badgeteam/hackerhotel-2024-hardware/README.md

# Hackerhotel 2024 badge

This repository contains the hardware desgin files for the Hackerhotel 2024 badge.

## License

Copyright 2024 Tilde.industries

Copyright 2024 Nicolai Electronics

This hardware design may be used under the terms of the [CERN-OHL-P](LICENSE) license.
