badgeteam/hackerhotel-2024-hardware/Misc/D2D8409C.jpg

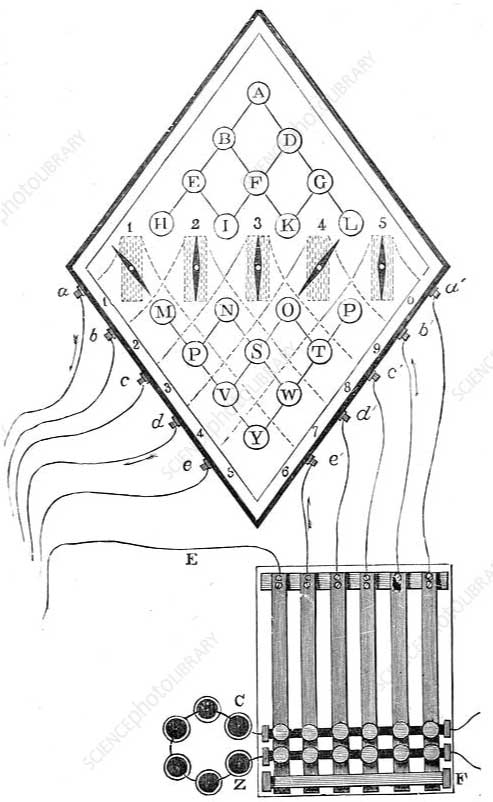
Misc/D2D8409C.jpg
