badgeteam/hackerhotel-2024-hardware/Misc/Hackerhotel.png

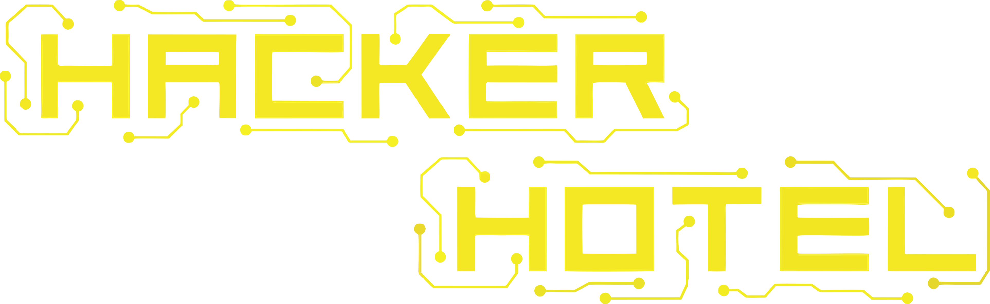
Misc/Hackerhotel.png
