badgeteam/hackerhotel-2024-hardware/Production/bom.xls

Comment | Designator | Footprint | JLCPCB Part # | quantity | quantity scaled
LED_Small | D5,D6,D7,D8,D9,D10,D11,D12,D13,D14,D15,D16,D17,D18,D19,D20,D21,D22,D23,D24 | BamboulabFootprints:XL-1606UOCSideStickerLED | C965861 | 20 | 10000
1A | F1 | tanoshii:Fuse_0805_2012Metric | C269107 | 1 | 500
NSR0320MW2T1G | D1,D2,D3,D4,D25 | tanoshii:D_SOD-323 | C48192 | 5 | 2500
1u | C14,C15,C16,C18,C19,C20,C21,C22,C23 | Capacitor_SMD:C_0805_2012Metric | C376929 | 9 | 4500
CH32V003F4U6 | U5 | vfd:QFN-20-1EP_3x3mm_P0.4mm_EP1.65x1.65mm | C5299908 | 1 | 500
Micro_SD_Card | J3 | tanoshii:MicroSD-SOFNG-TF-002-H18 | C125814 | 1 | 500
E-Paper | J6 | tanoshii:Hirose_FH12-24S-0.5SH_1x24-1MP_P0.50mm_Horizontal | C202112 | 1 | 500
100n | C2,C4,C5,C9,C13 | Capacitor_SMD:C_0805_2012Metric | C476766 | 5 | 2500
USB-C | J4 | tanoshii:USB_C_Receptacle_HRO_TYPE-C-31-M-12 | C165948 | 1 | 500
SW_SPDT | SW6 | Button_Switch_SMD:SW_SPDT_PCM12 | C319020 | 1 | 500
Battery | J5 | tanoshii:JST_S2B-ZR-SM4A-TF(LF)(SN) | C265329 | 1 | 500
30 | R23,R24,R25,R26,R27 | Resistor_SMD:R_0805_2012Metric | C25305 | 5 | 2500
AP2302B | Q1,Q2,Q3 | tanoshii:SOT-23 | C406812 | 3 | 1500
22u | C6,C10,C11 | Capacitor_SMD:C_0805_2012Metric | C602037 | 3 | 1500
SANYOU_SRD_Form_C | K1 | BamboulabFootprints:HRS1H-S-DC3V | C136110 | 1 | 500
Multi-Directional-Switches | SW1,SW2,SW3,SW4,SW5 | BamboulabFootprints:TM-2023 | C318951 | 5 | 2500
10k | R1,R6,R7,R8,R11,R14,R17,R28,R29,R30,R34,R43 | Resistor_SMD:R_0805_2012Metric | C510098 | 12 | 6000
2.2u | L1 | tanoshii:Inductor_MSC20FC | C375944 | 1 | 500
45.3k | R12 | Resistor_SMD:R_0805_2012Metric | C5266157 | 1 | 500
5.1k | R4,R5 | Resistor_SMD:R_0805_2012Metric | C2930296 | 2 | 1000
47u | L2 | tanoshii:L_1210_3225Metric | C83083 | 1 | 500
Breakoutpads | J2 | Connector_PinHeader_2.54mm:PinHeader_1x03_P2.54mm_Vertical | C2935909 | 1 | 500
XT4054K421MR-G | U3 | tanoshii:SOT-23-5 | C141405 | 1 | 500
4u7 | C17 | Capacitor_SMD:C_0805_2012Metric | C2918489 | 1 | 500
22p | C8 | Capacitor_SMD:C_0805_2012Metric | C5137614 | 1 | 500
10u | C7,C12 | Capacitor_SMD:C_0805_2012Metric | C105506 | 2 | 1000
2k | R13 | Resistor_SMD:R_0805_2012Metric | C3017846 | 1 | 500
100k | R16,R18,R19,R31,R32 | Resistor_SMD:R_0805_2012Metric | C2907293 | 5 | 2500
4.7k | R2,R3,R20 | Resistor_SMD:R_0805_2012Metric | C2907326 | 3 | 1500
27 | R9,R10,R21 | Resistor_SMD:R_0805_2012Metric | C2907314 | 3 | 1500
1k | R15,R35 | Resistor_SMD:R_0805_2012Metric | C3017842 | 2 | 1000
 | U2 |  | C133751 | 1 | 500
 | U4 |  | C55136 | 1 | 500
