badgeteam/hackerhotel-2024-hardware/HH2024 V1.4 Schematic.pdf

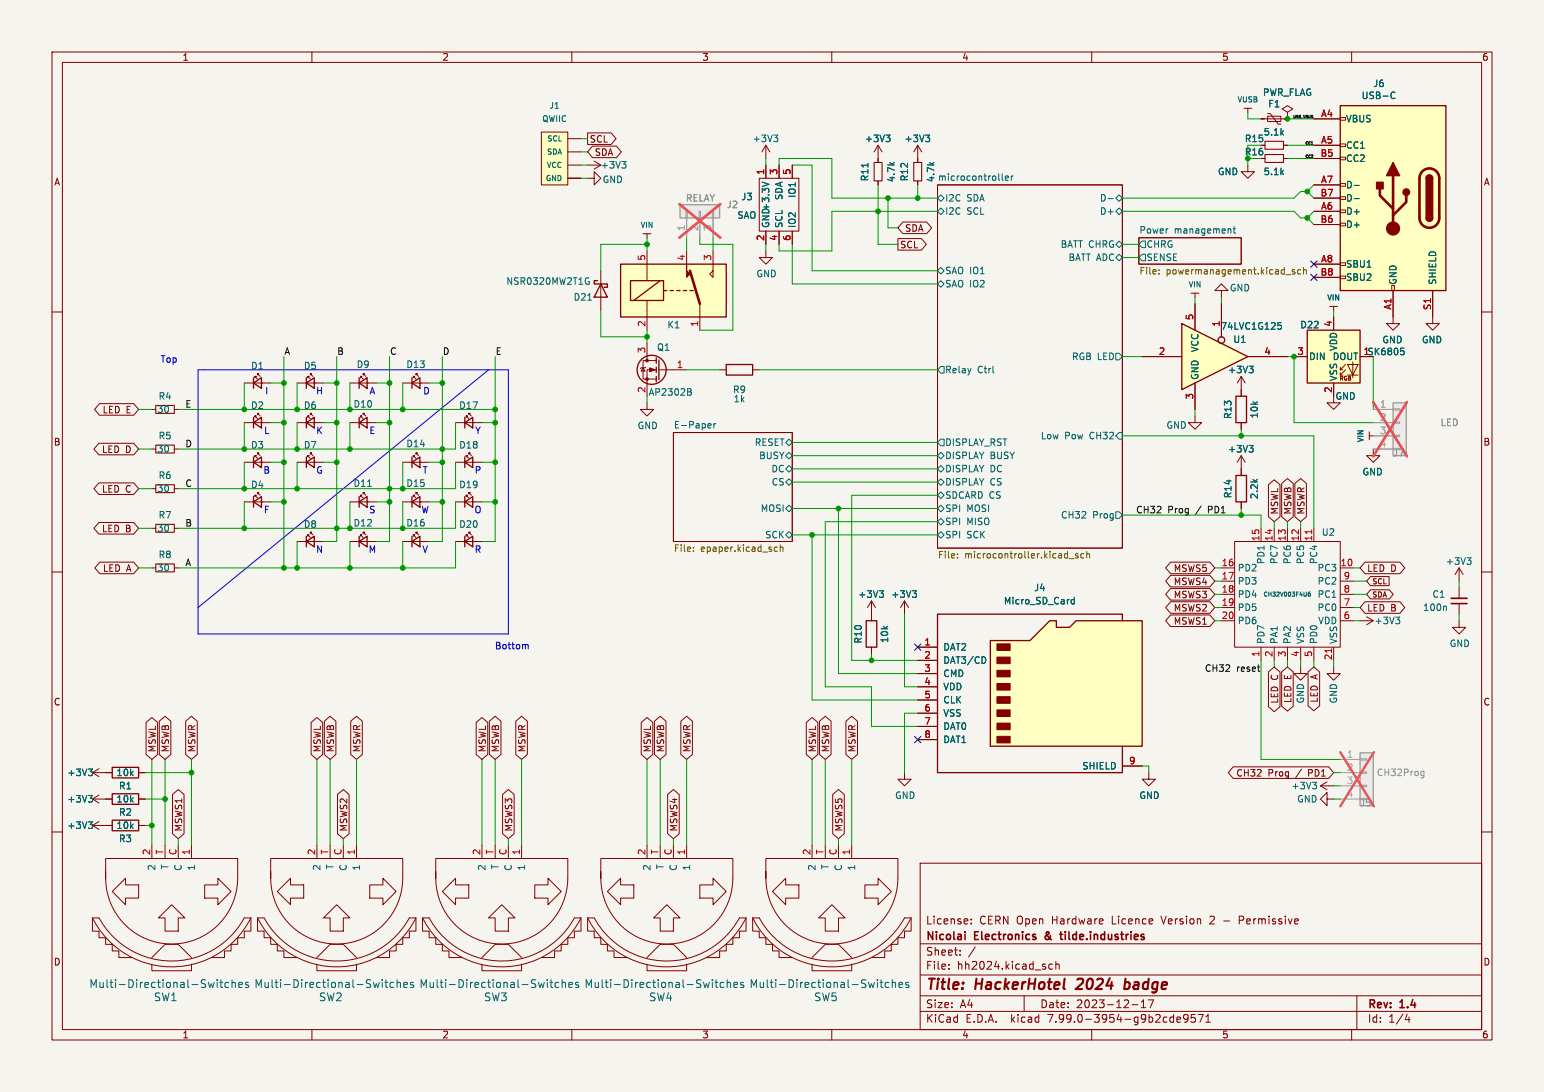
[picture p3: page 1]

Power management File: powermanagement.kicad_sch BUSY RESET DC

SPI MOSI SPI SCK DISPLAY DC

SCL LED D LED A LED C LED E CH32 Prog / PD1 MSWL MSWB

T SW5 Multi-Directional-Switches DAT2 1 DAT3/CD 2 CMD 3 VDD 4 CLK 5 VSS 6 DAT0 7 DAT1 8 SHIELD 9

Id: 1/4 Title: HackerHotel 2024 badge

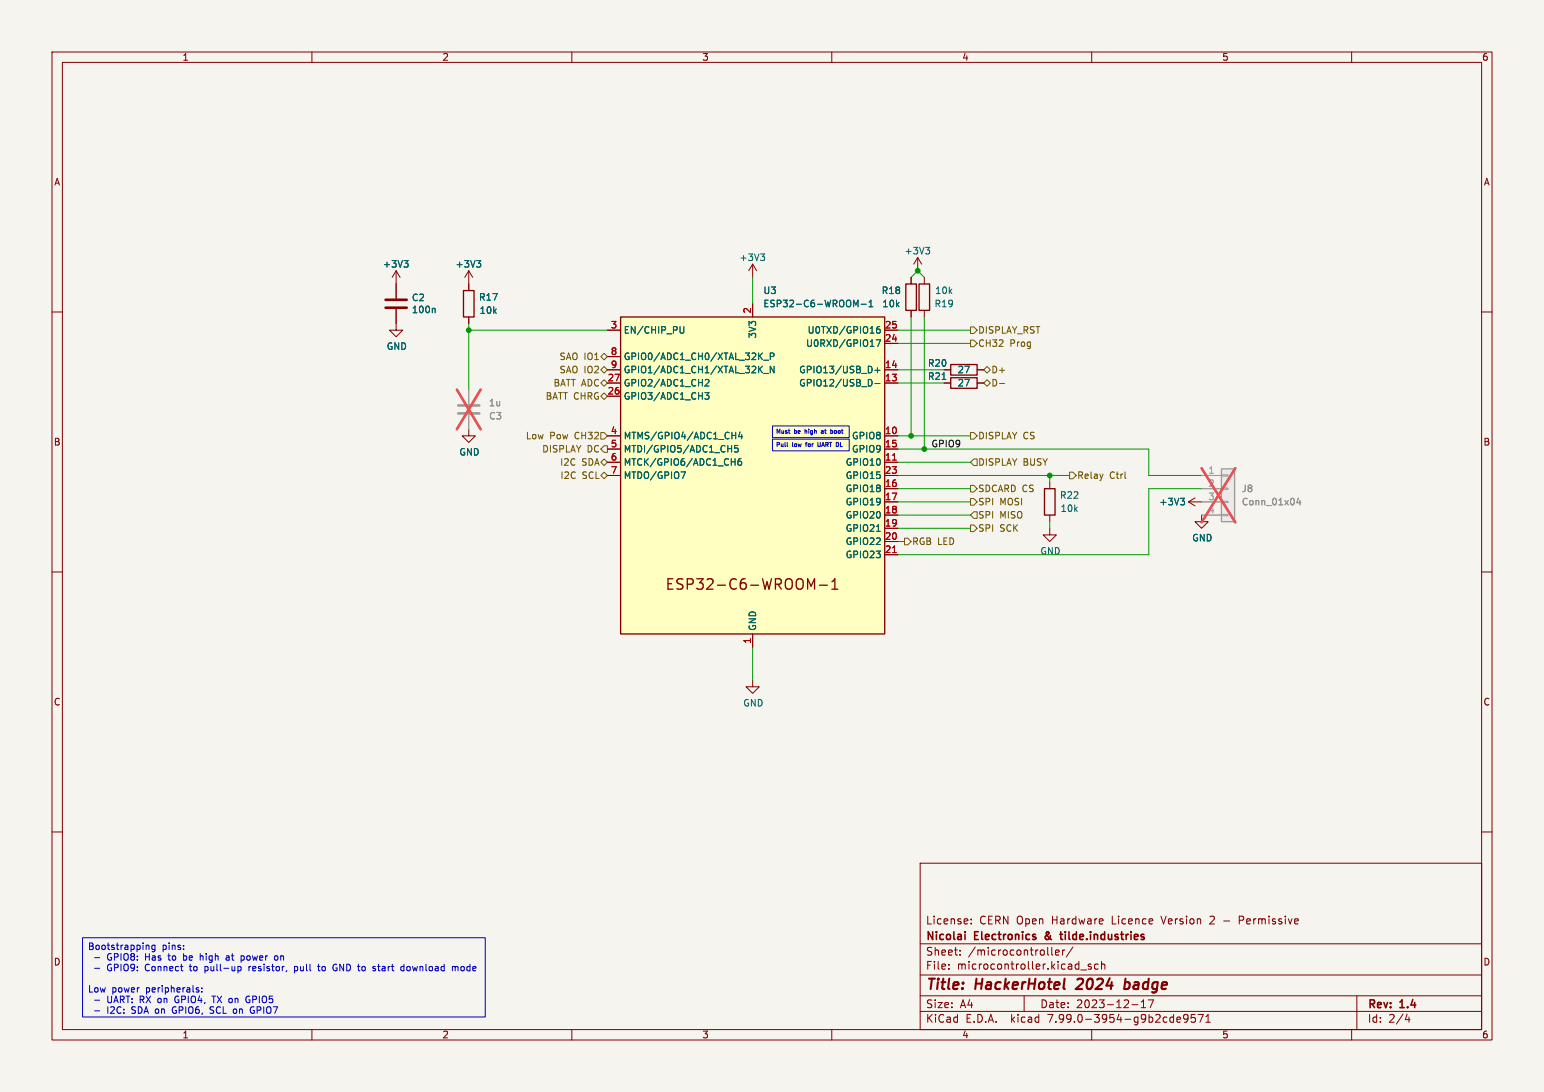
[picture p4: page 2]

2 GPIO22 20 GPIO23 21 GPIO15 23 U0RXD/GPIO17 24 U0TXD/GPIO16 25 GPIO3/ADC1_CH3 26 GPIO2/ADC1_CH2 27 EN/CHIP_PU 3 MTMS/GPIO4/ADC1_CH4 4 MTDI/GPIO5/ADC1_CH5 5 MTCK/GPIO6/ADC1_CH6 6 MTDO/GPIO7 7 GPIO0/ADC1_CH0/XTAL_32K_P 8 GPIO1/ADC1_CH1/XTAL_32K_N 9 U3ESP32-C6-WROOM-1 R20

SPI SCK DISPLAY_RST DISPLAY CS CH32 Prog D+

2 GPIO22 20 GPIO23 21 GPIO15 23 U0RXD/GPIO17 24 U0TXD/GPIO16 25 GPIO3/ADC1_CH3 26 GPIO2/ADC1_CH2 27 EN/CHIP_PU 3 MTMS/GPIO4/ADC1_CH4 4 MTDI/GPIO5/ADC1_CH5 5 MTCK/GPIO6/ADC1_CH6 6 MTDO/GPIO7 7 GPIO0/ADC1_CH0/XTAL_32K_P 8 GPIO1/ADC1_CH1/XTAL_32K_N 9 C3

SPI MOSI DISPLAY BUSY

Id: 2/4 Title: HackerHotel 2024 badge

Low power peripherals: - UART: RX on GPIO4, TX on GPIO5

- I2C: SDA on GPIO6, SCL on GPIO7

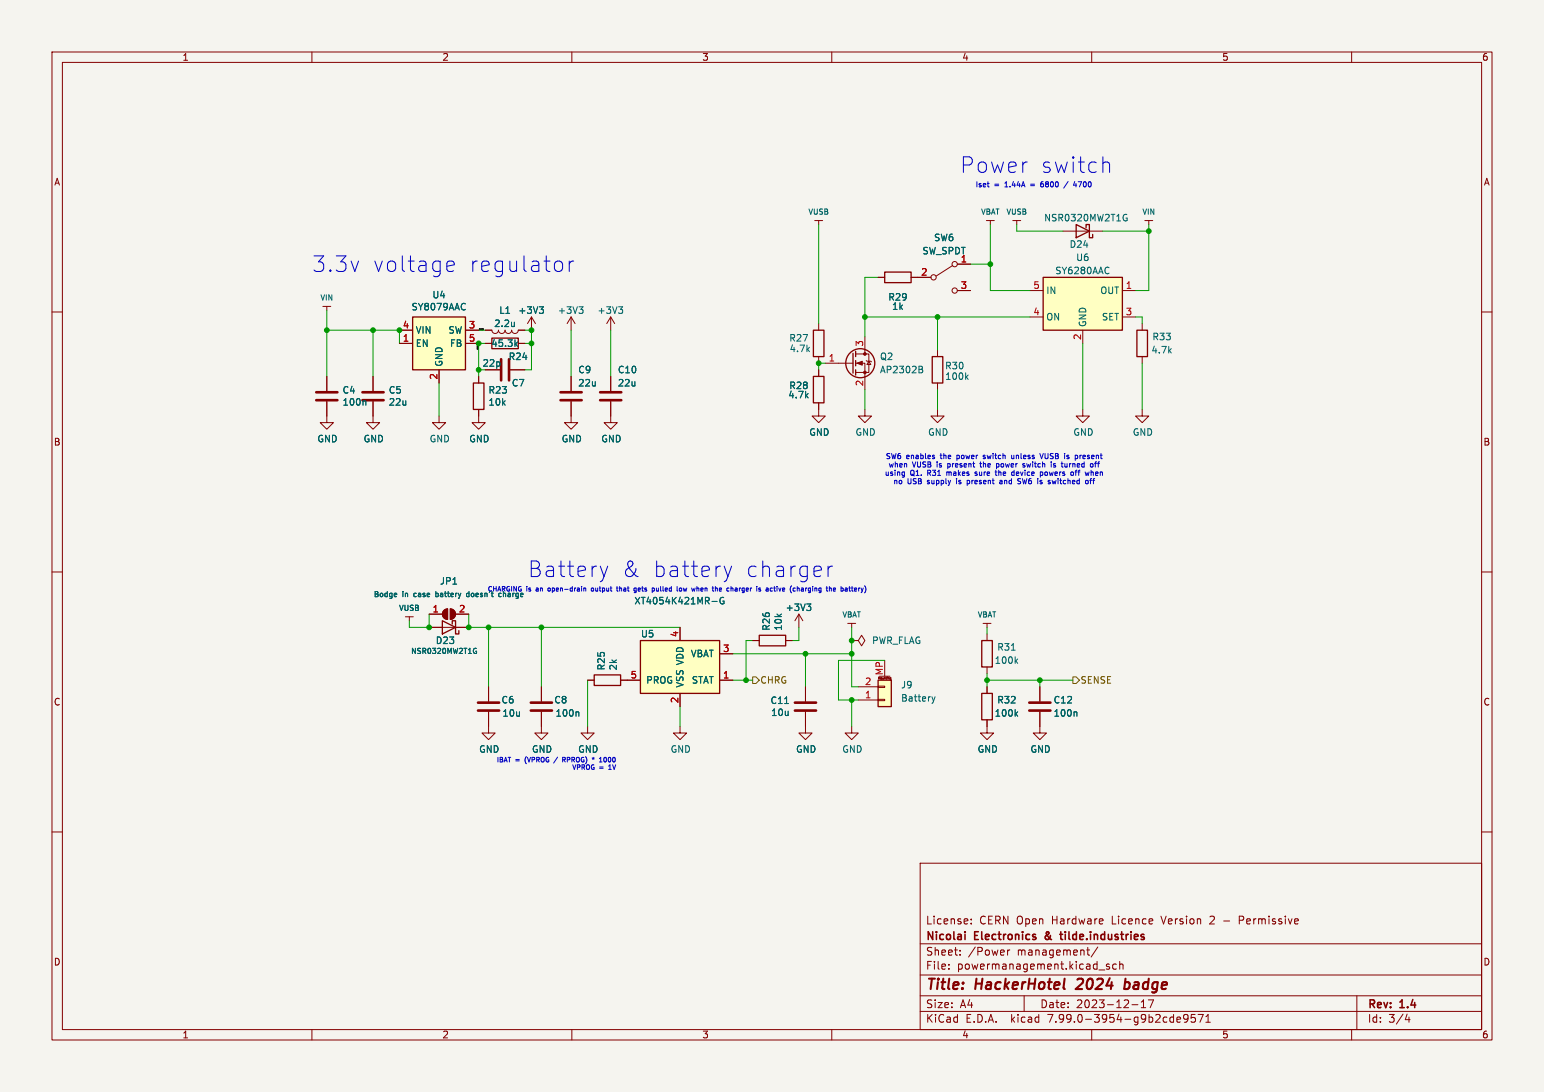
[picture p5: page 3]

Iset = 1.44A = 6800 / 4700 SW6 enables the power switch unless VUSB is present when VUSB is present the power switch is turned off using Q1. R31 makes sure the device powers off when

IBAT = (VPROG / RPROG) * 1000 VPROG = 1V Battery & battery charger

Id: 3/4 Title: HackerHotel 2024 badge

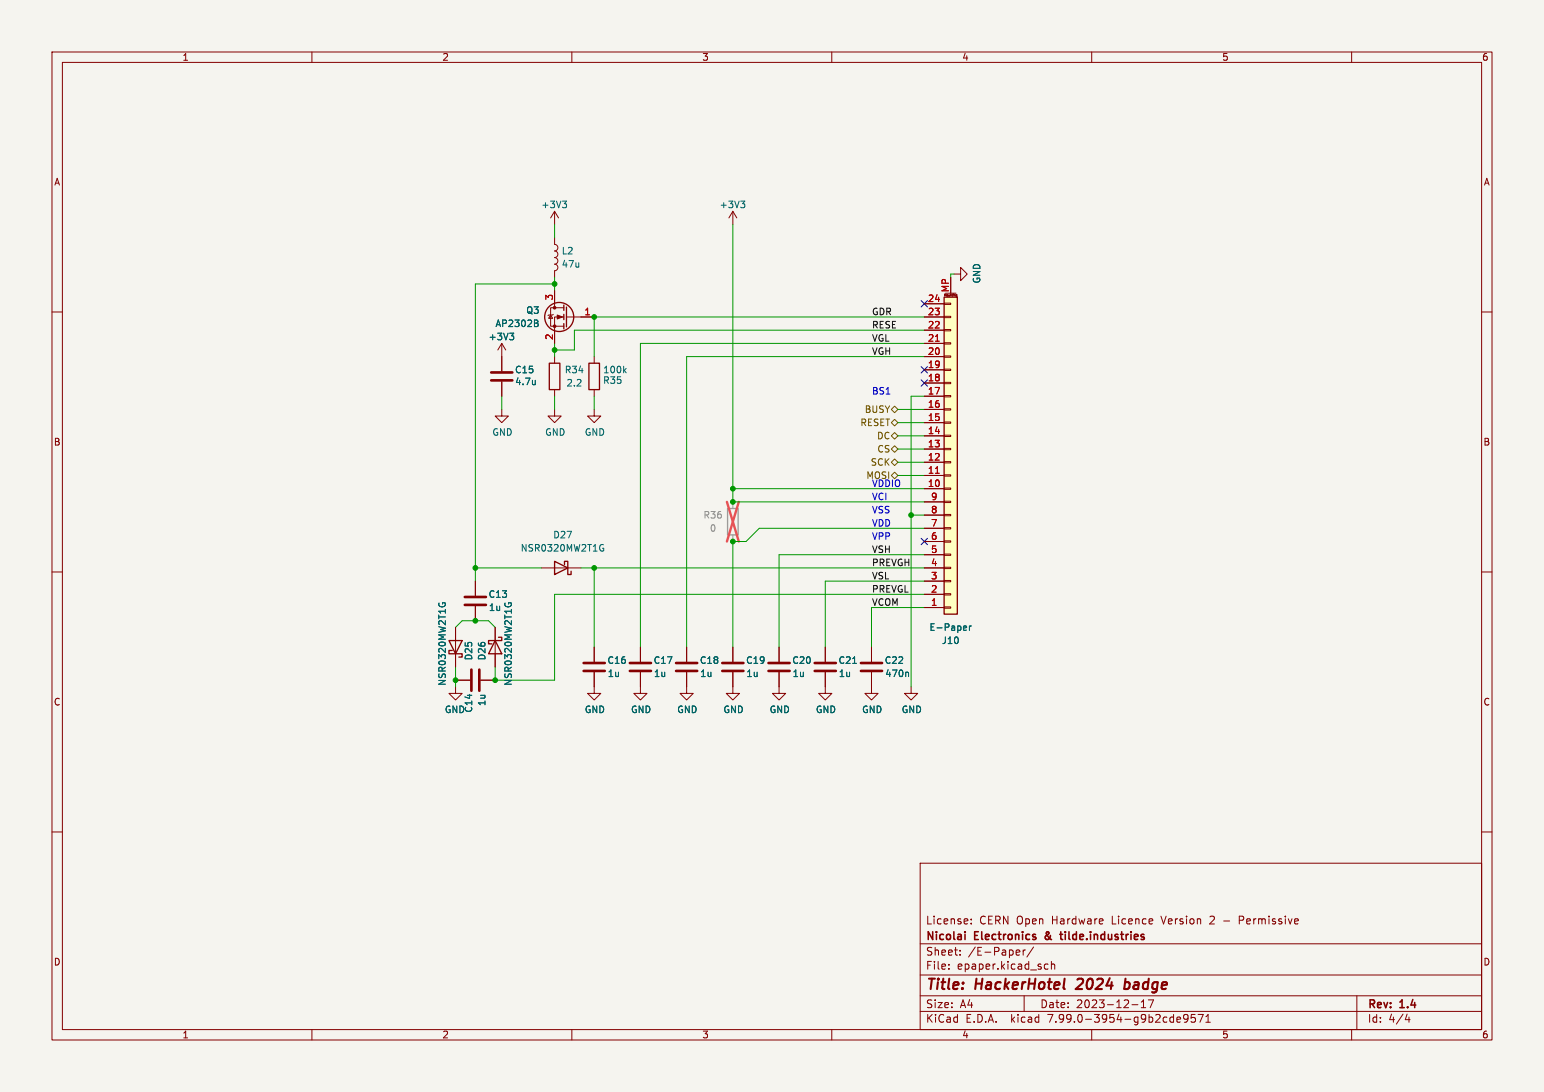
[picture p6: page 4]

9 MP VGH 20 20

Mounting 1
BUSY MOSI RESET VSH GDR

VGL RESE 22 22

VSL PREVGH | 4 4

PREVGL VCOM | 2 2

Id: 4/4 Title: HackerHotel 2024 badge
