badgeteam/hackerhotel-2024-hardware/hackerhotel-2024-hardware-renze/Schematic.pdf

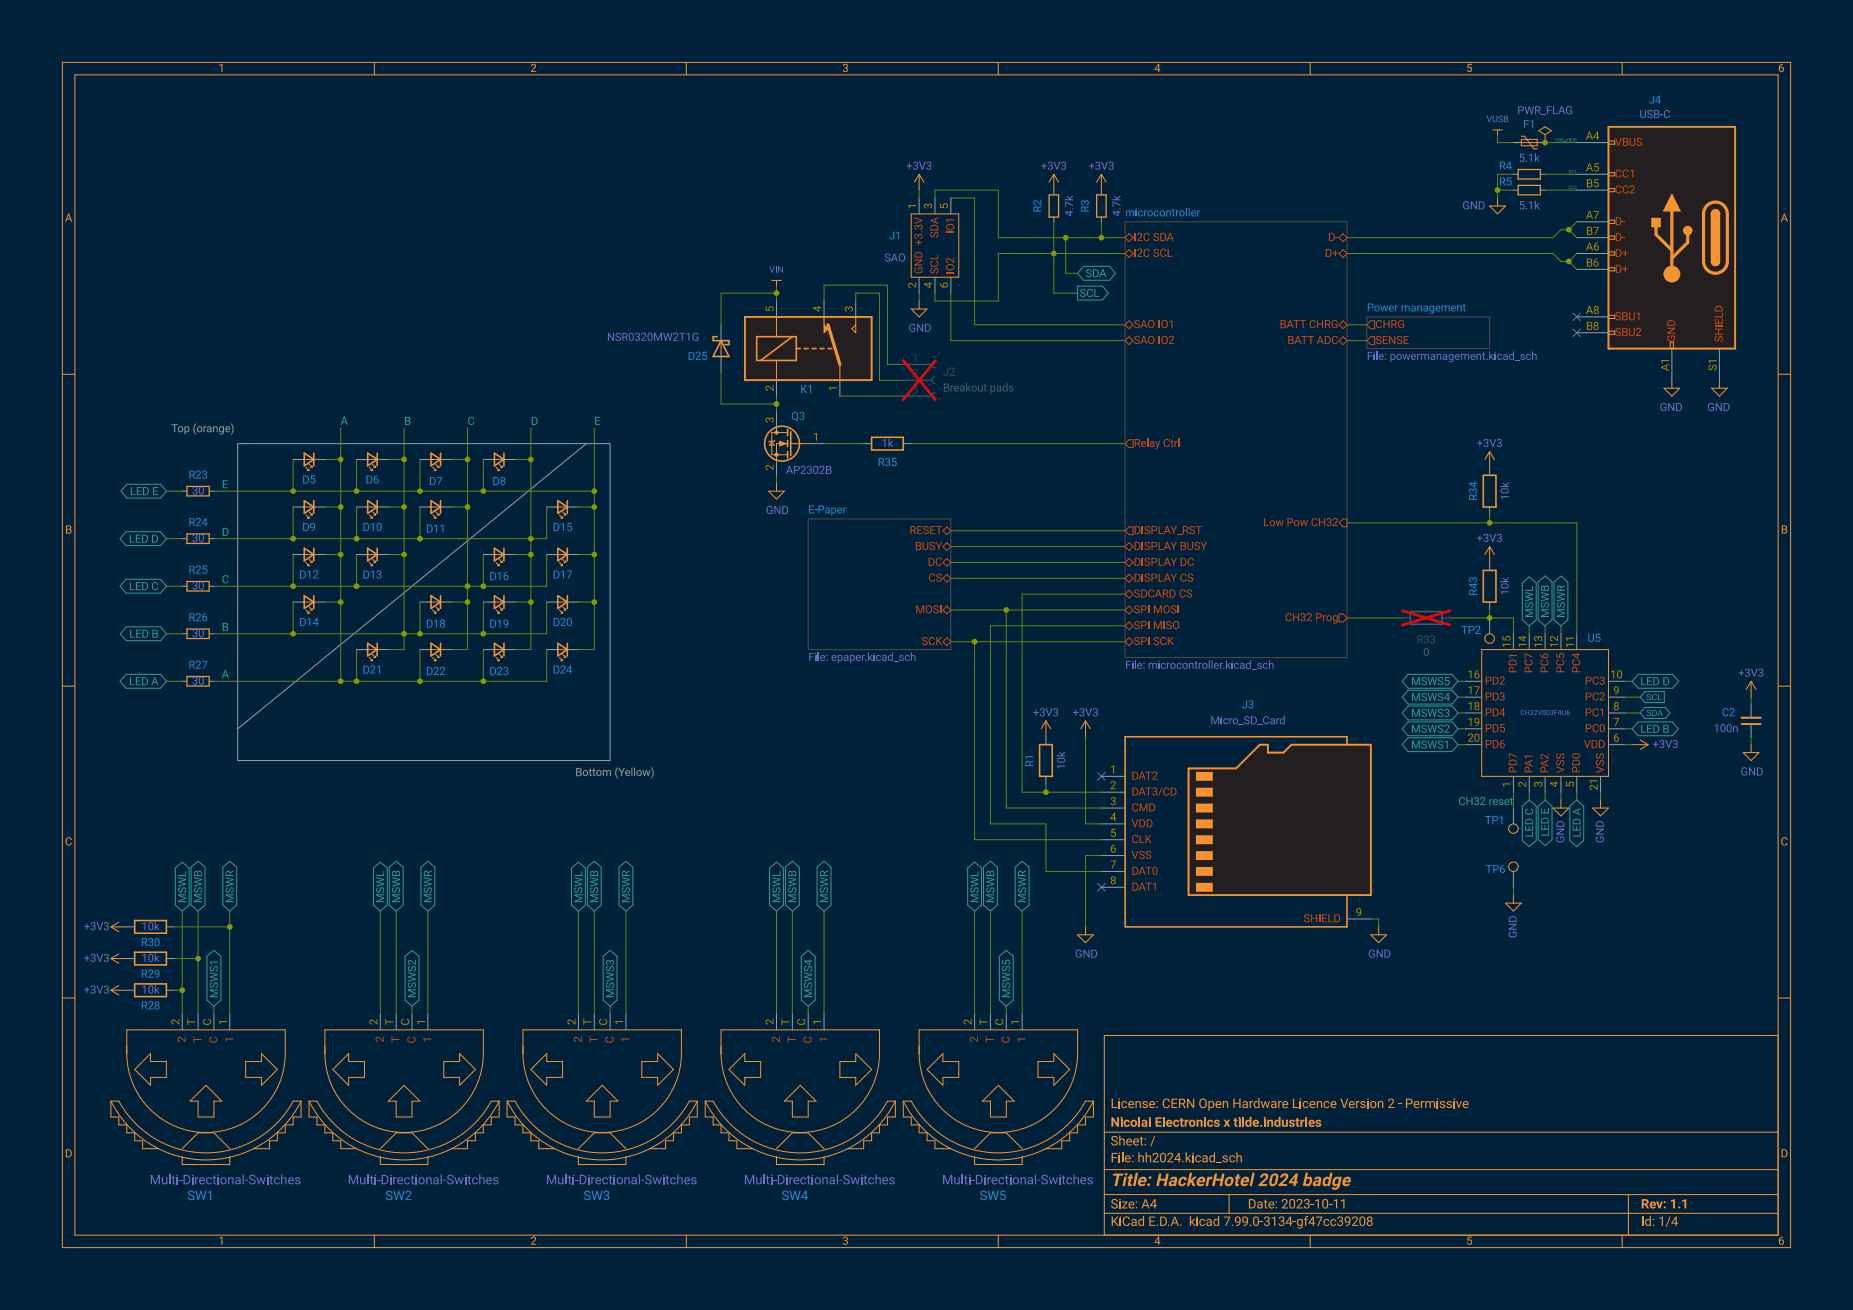
[picture p7: page 1]

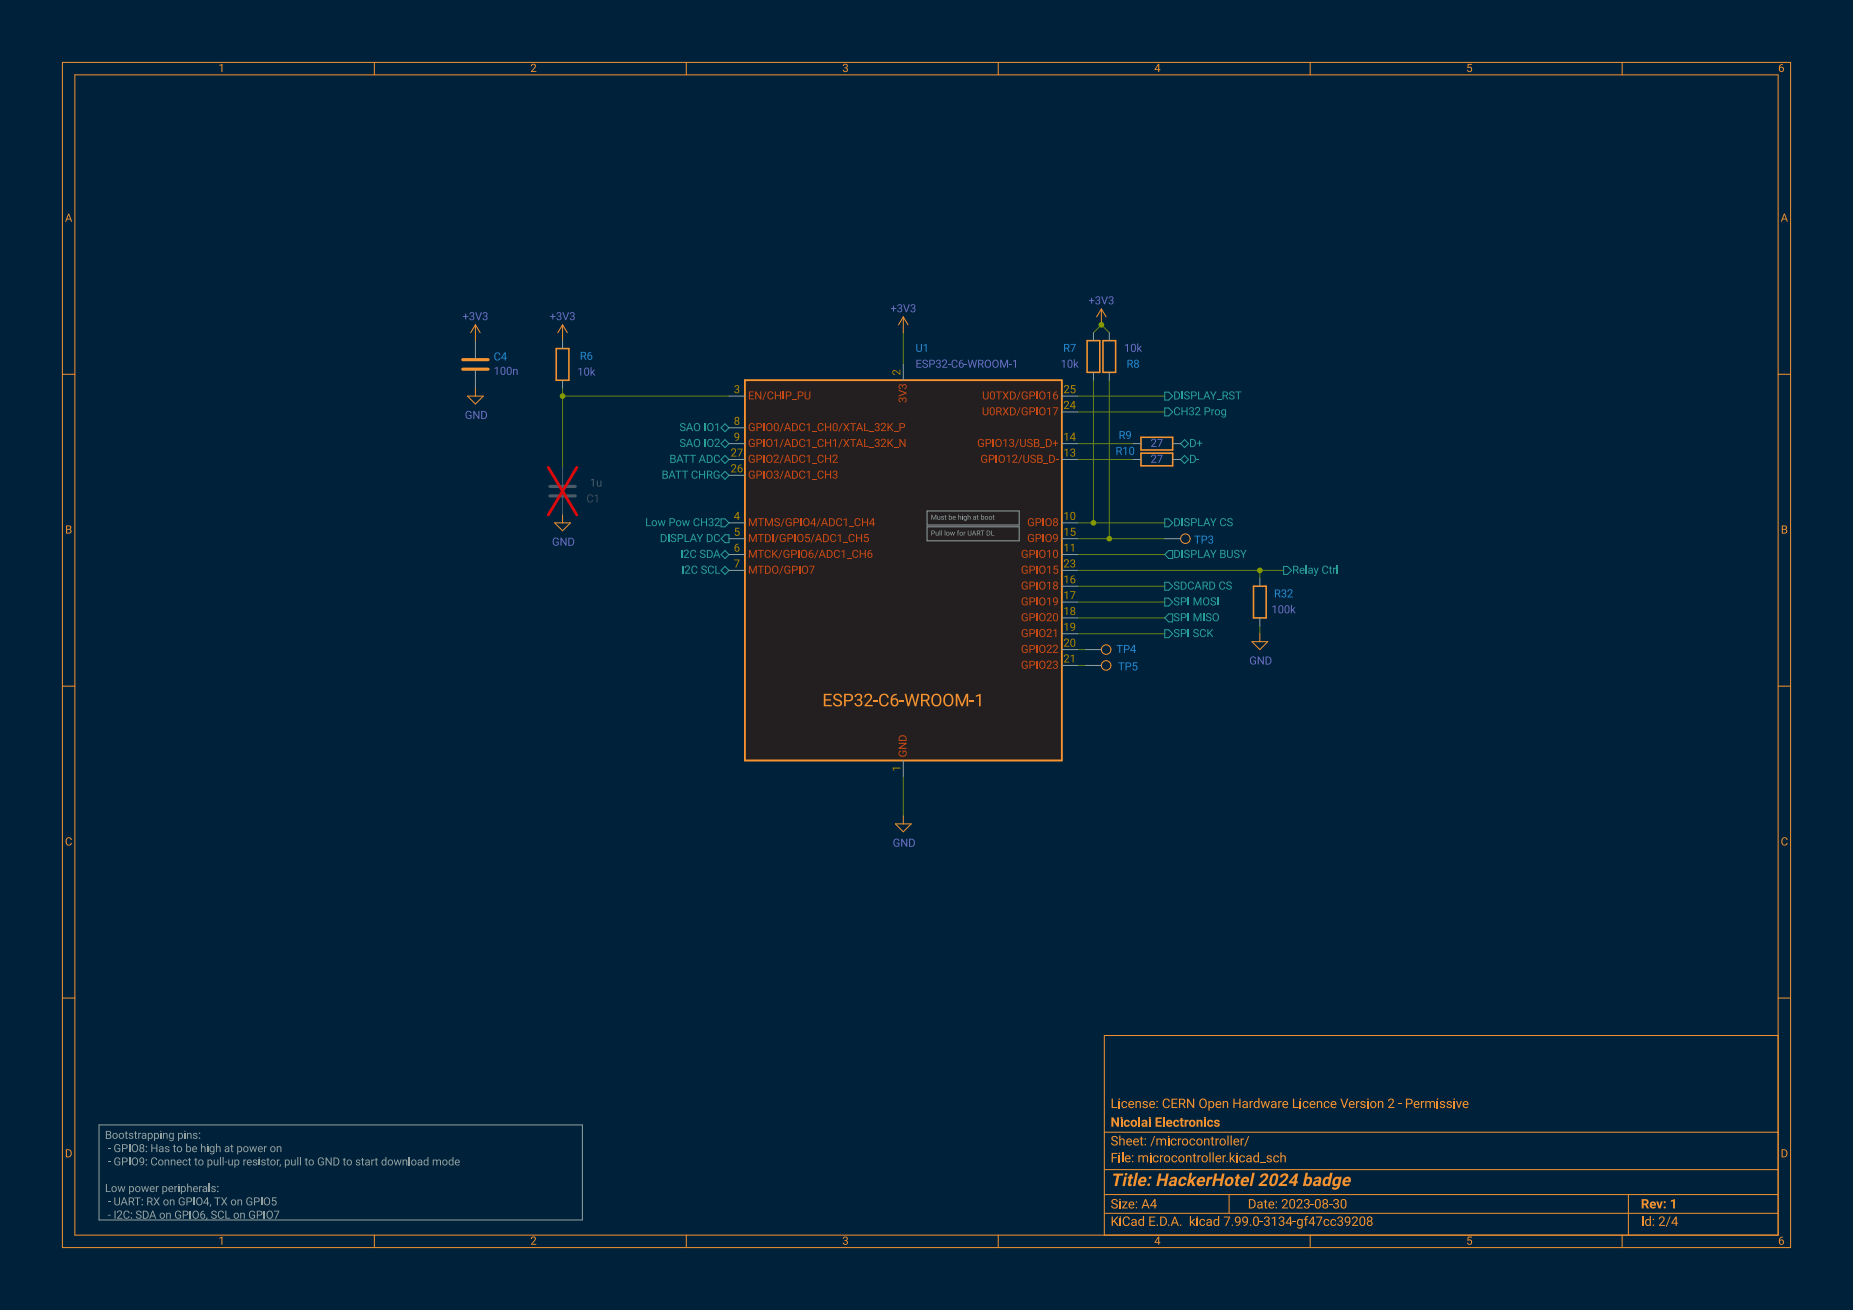
[picture p8: page 2]

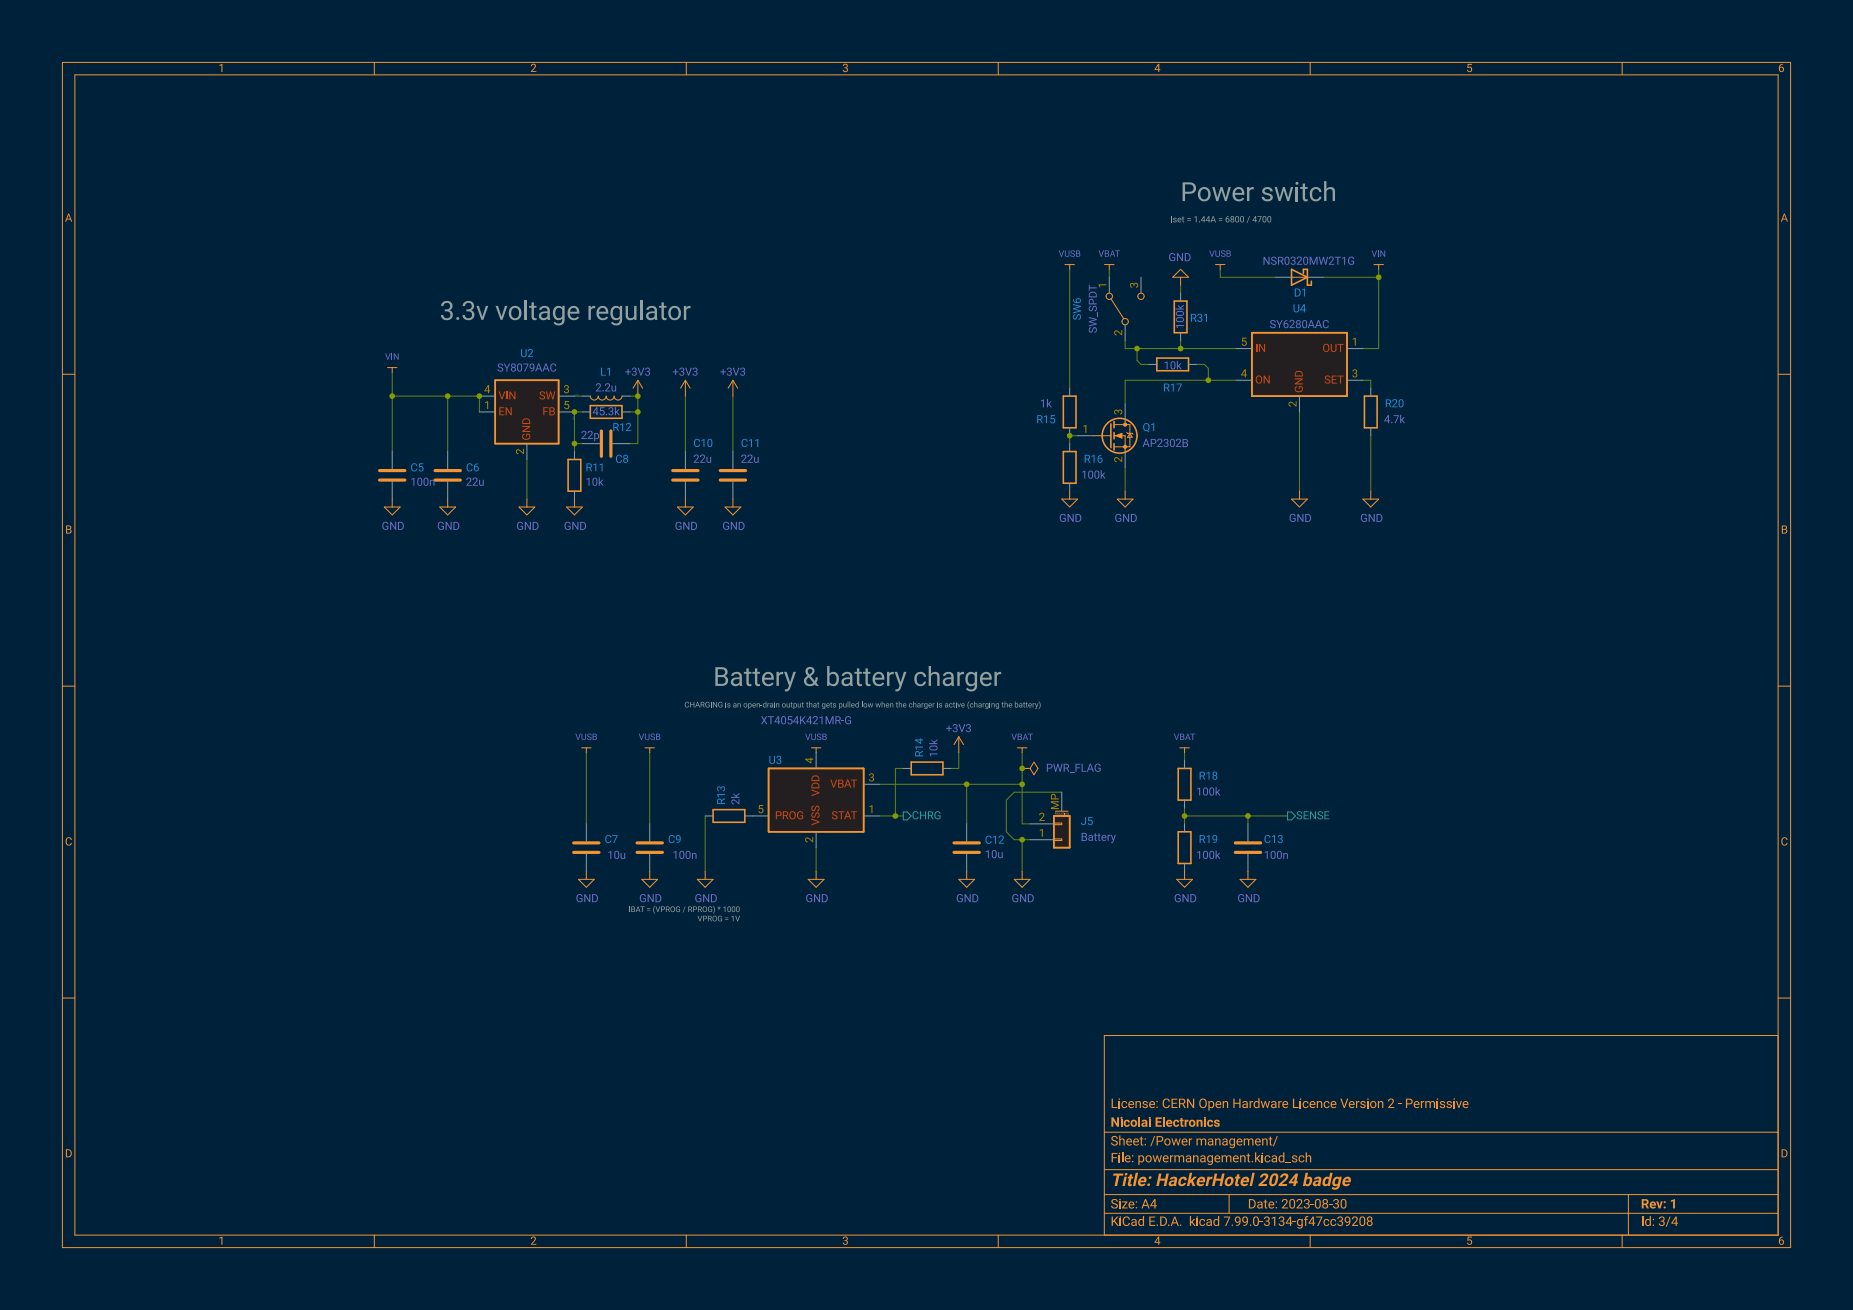
[picture p9: page 3]

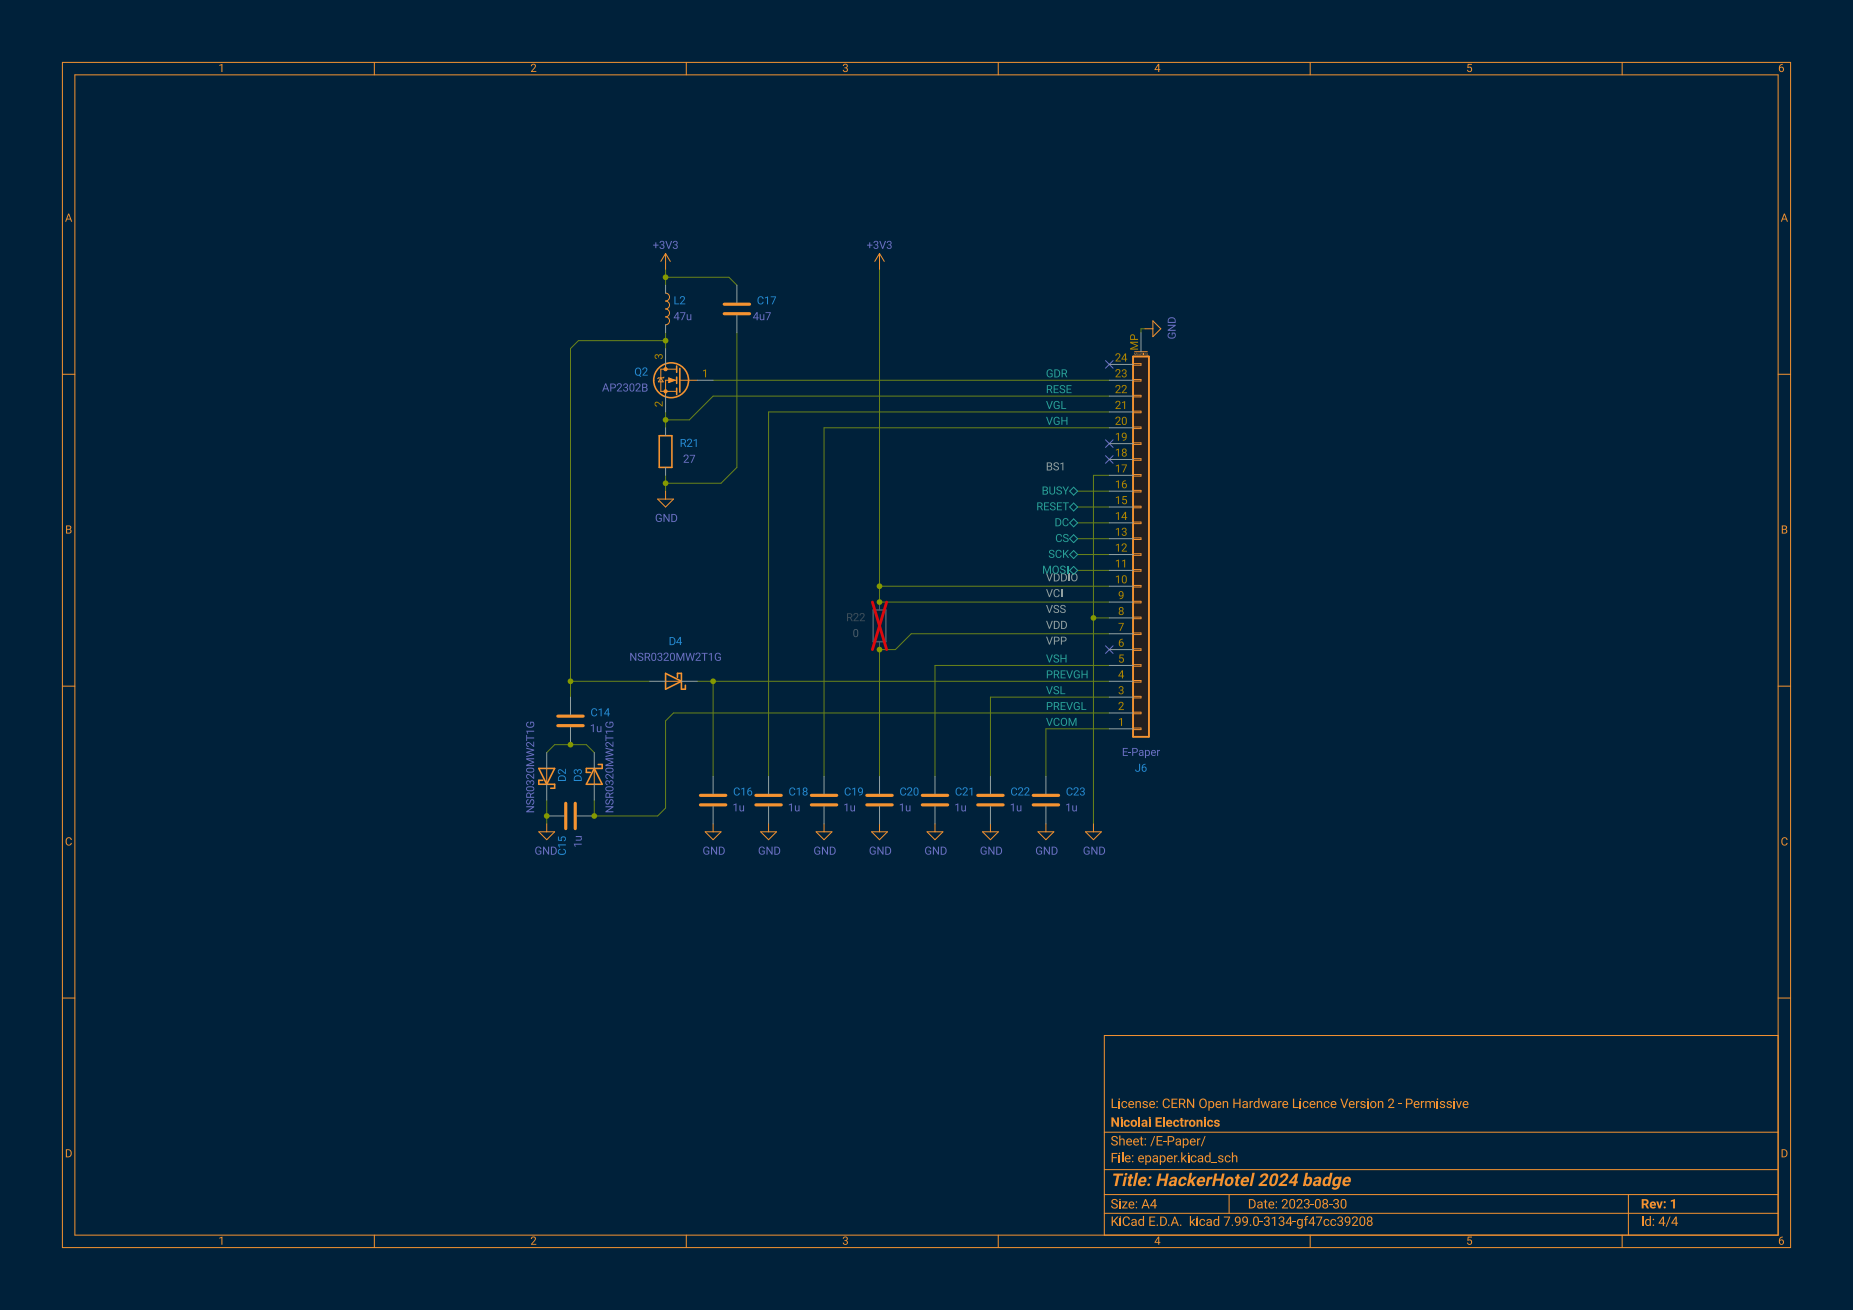
[picture p10: page 4]
