badgeteam/hackerhotel-2024-hardware/hackerhotel-2024-hardware-renze/test.pdf

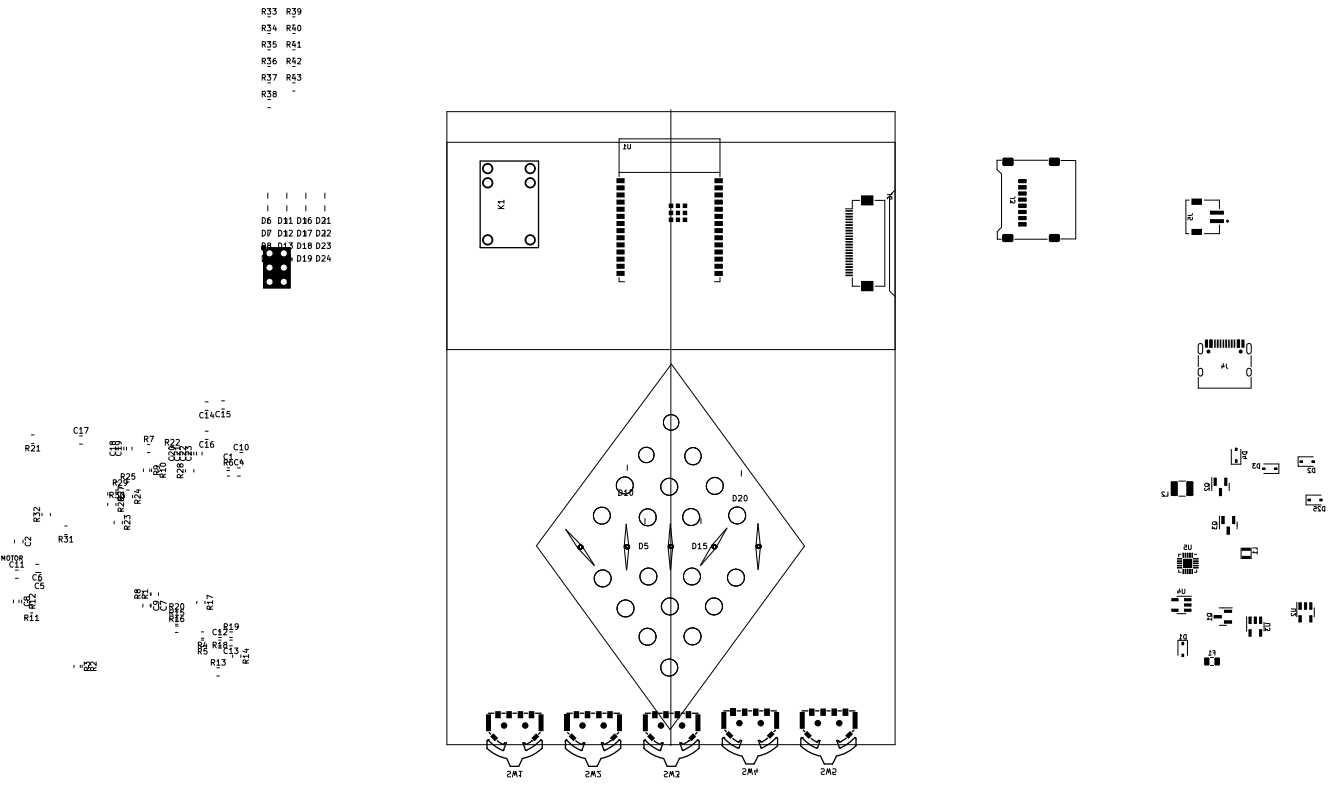
[picture p11: page 1]
