badgeteam/hackerhotel-2024-hardware/hackerhotel-2024-hardware-renze/hh2024.kicad_pcb

## KiCad design hackerhotel-2024-hardware-renze/hh2024.kicad_pcb (2023-10-17)

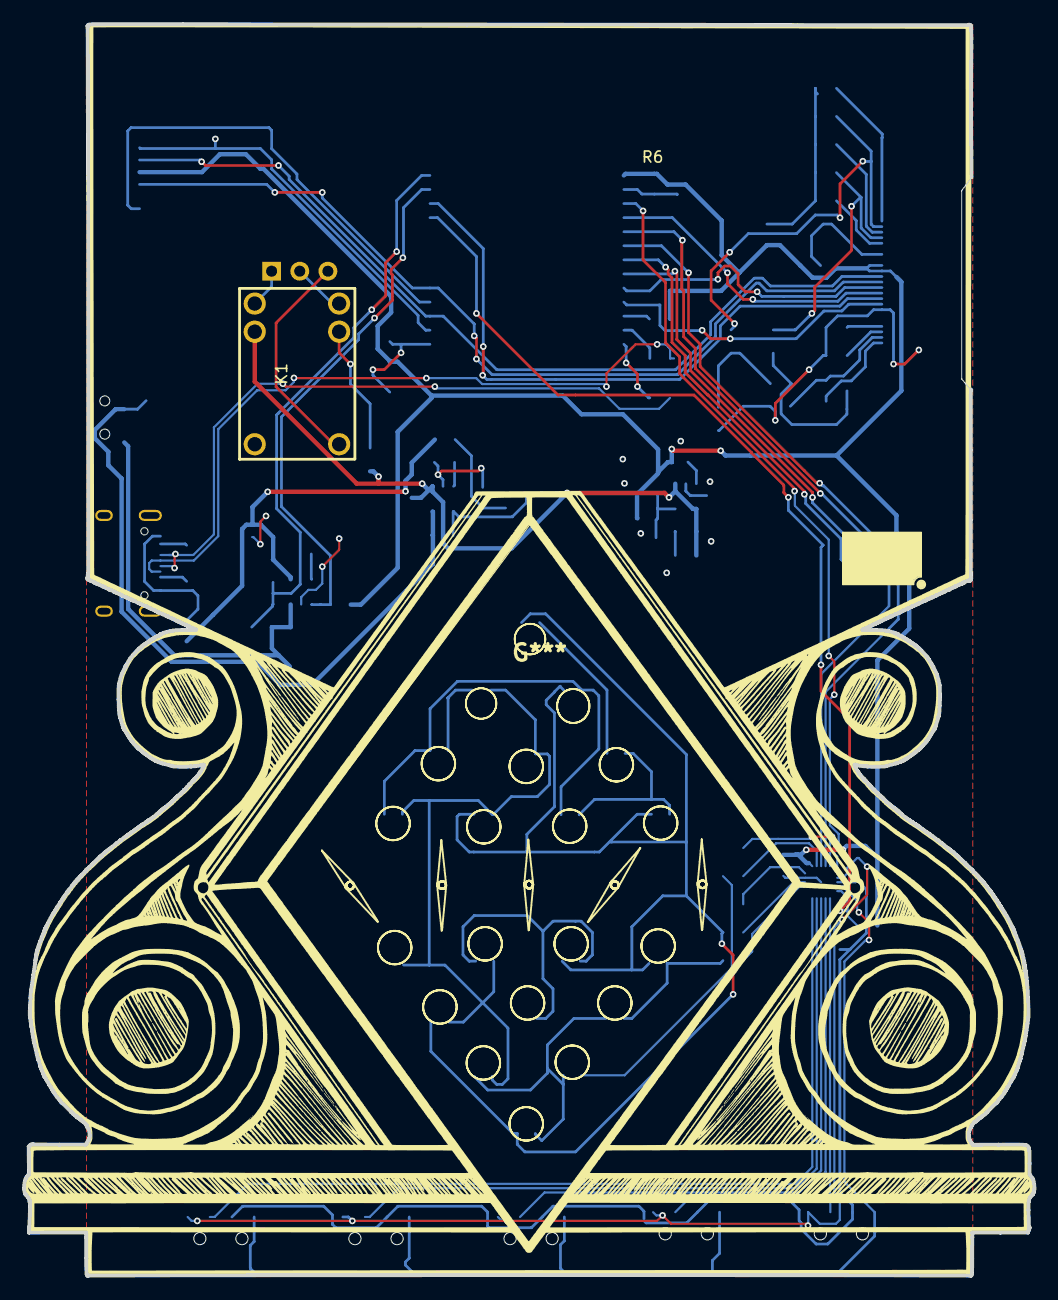
[picture p12: board hh2024.kicad_pcb from above]

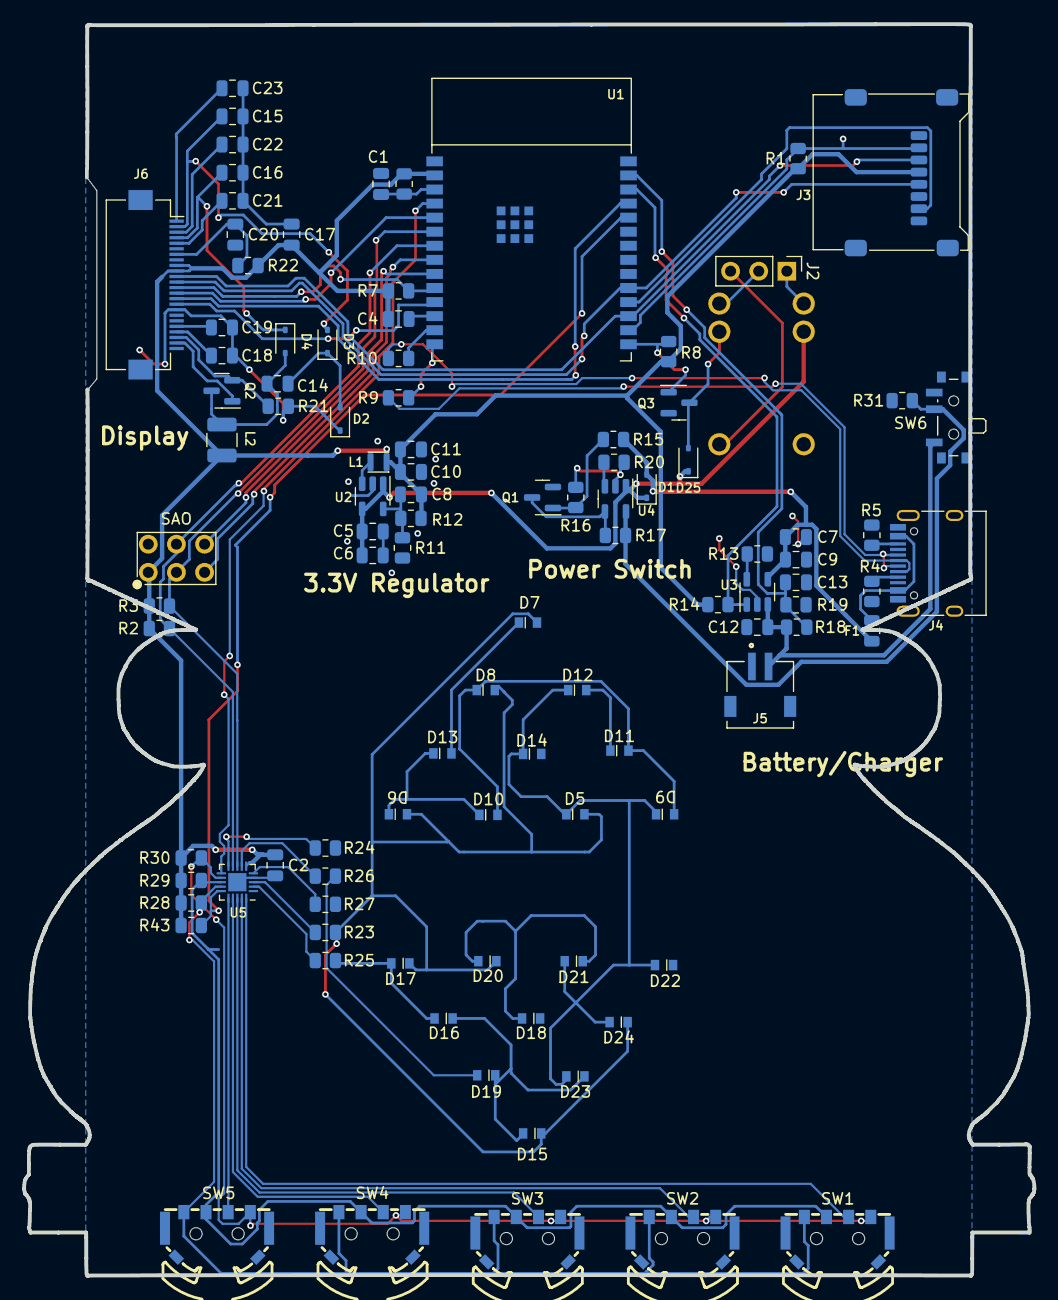
[picture p13: board hh2024.kicad_pcb from below]

Board: 2 copper layers, 91.2 x 113.0 mm, 103 parts (102 on the bottom side), 71 nets.

Parts:
C1, C14, C15, C16, C18, C19, C20, C21, C22, C23: 1u; C_0805_2012Metric
C2, C4, C5, C9, C13: 100n; C_0805_2012Metric
C6, C10, C11: 22u; C_0805_2012Metric
C7, C12: 10u; C_0805_2012Metric
C8: 22p; C_0805_2012Metric
C17: 4u7; C_0805_2012Metric
D1, D2, D3, D4, D25: NSVR0320MW2T1G; D_SOD-323
D5, D6, D7, D8, D9, D10, D11, D12, D13, D14, D15, D16, D17, D18, D19, D20, D21, D22, D23, D24: LED_Small; XL-1606UOC Side Sticker LED
F1: 1A; Fuse_0805_2012Metric
J1: SAO; SAO2
J2: Breakout pads; PinHeader_1x03_P2.54mm_Vertical
J3: Micro_SD_Card; MicroSD-SOFNG-TF-002-H18
J4: USB-C; USB_C_Receptacle_HRO_TYPE-C-31-M-12
J5: Battery; JST_S2B-ZR-SM4A-TF(LF)(SN)
J6: E-Paper; Hirose_FH12-24S-0.5SH_1x24-1MP_P0.50mm_Horizontal
K1: SANYOU_SRD_Form_C; HRS1H-S-DC3V
L1: 2.2u; Inductor_MSC20FC
L2: 47u; L_1210_3225Metric
Q1, Q2, Q3: AP2302B; SOT-23
R1, R6, R7, R8, R11, R14, R17, R28, R29, R30, R43: 10k; R_0805_2012Metric
R2, R3: 4k7; R_0805_2012Metric
R4, R5: 5.1k; R_0805_2012Metric
R9, R10, R21: 27; R_0805_2012Metric
R12: 45.3k; R_0805_2012Metric
R13: 2k; R_0805_2012Metric
R15: 1k; R_0805_2012Metric
R16, R18, R19, R31: 100k; R_0805_2012Metric
R20: 4.7k; R_0805_2012Metric
R22: 0; R_0805_2012Metric
R23, R24, R25, R26, R27: 30; R_0805_2012Metric
SW1, SW2, SW3, SW4, SW5: Multi-Directional-Switches; TM-2023
SW6: SW_SPDT; SW_SPDT_PCM12
U1: ESP32-C6-WROOM-1
U2: SY8079AAC; SOT-23-5
U3: XT4054K421MR-G; SOT-23-5
U4: SY6280AAC; SOT-23-5
U5: CH32V003F4U6; QFN-20-1EP_3x3mm_P0.4mm_EP1.65x1.65mm

Connections:
+3V3: C2.2, C4.1, C8.1, C10.1, C11.1, C17.2, J1.1 (+3.3V), J3.4 (VDD), J6.9, J6.10, L1.1, L2.1, R1.1, R2.2, R3.2, R6.2, R7.2, R8.1, R12.1, R14.2, R22.1, R28.1, R29.1, R30.1, R43.1, U1.2 (3V3), U5.6 (VDD)
/A: D5.1 (K), D9.1 (K), D12.1 (K), D14.1 (K), D21.2 (A), D22.2 (A), D23.2 (A), D24.2 (A), R27.2
/B: D6.1 (K), D10.1 (K), D13.1 (K), D14.2 (A), D18.2 (A), D19.2 (A), D20.2 (A), D21.1 (K), R26.2
/C: D7.1 (K), D11.1 (K), D12.2 (A), D13.2 (A), D16.2 (A), D17.2 (A), D18.1 (K), D22.1 (K), R25.2
/CC1: J4.A5 (CC1), R4.2
/CC2: J4.B5 (CC2), R5.2
/D: D8.1 (K), D9.2 (A), D10.2 (A), D11.2 (A), D15.2 (A), D16.1 (K), D19.1 (K), D23.1 (K), R24.2
/E: D5.2 (A), D6.2 (A), D7.2 (A), D8.2 (A), D15.1 (K), D17.1 (K), D20.1 (K), D24.1 (K), R23.2
/E-Paper/BUSY: J6.16, U1.11 (GPIO10)
/E-Paper/CS: J6.13, R7.1, U1.10 (GPIO8)
/E-Paper/DC: J6.14, U1.5 (MTDI/GPIO5/ADC1_CH5)
/E-Paper/GDR: J6.23, Q2.1 (G)
/E-Paper/MOSI: J3.3 (CMD), J6.11, U1.17 (GPIO19)
/E-Paper/PREVGH: C16.2, D4.1 (K), J6.4
/E-Paper/PREVGL: C15.1, D3.2 (A), J6.2
/E-Paper/RESE: J6.22, Q2.2 (S), R21.2
/E-Paper/RESET: J6.15, U1.25 (U0TXD/GPIO16)
/E-Paper/SCK: J3.5 (CLK), J6.12, U1.19 (GPIO21)
/E-Paper/VCOM: C23.2, J6.1
/E-Paper/VGH: C19.2, J6.20
/E-Paper/VGL: C18.2, J6.21
/E-Paper/VSH: C21.2, J6.5
/E-Paper/VSL: C22.2, J6.3
/Power management/CHRG: R14.1, U1.26 (GPIO3/ADC1_CH3), U3.1 (STAT)
/Power management/FB33: C8.2, R11.1, R12.2, U2.5 (FB)
/Power management/SENSE: C13.1, R18.1, R19.2, U1.27 (GPIO2/ADC1_CH2)
/Power management/SW33: L1.2, U2.3 (SW)
/USB_VBUS: F1.2, J4.A4 (VBUS), J4.A9 (VBUS), J4.B4 (VBUS), J4.B9 (VBUS)
/microcontroller/CH32 Prog: R43.2, U1.24 (U0RXD/GPIO17), U5.15 (PD1)
/microcontroller/D+: J4.A6 (D+), J4.B6 (D+), R9.1
/microcontroller/D-: J4.A7 (D-), J4.B7 (D-), R10.1
/microcontroller/Low Pow CH32: U1.4 (MTMS/GPIO4/ADC1_CH4), U5.11 (PC4)
/microcontroller/Relay Ctrl: Q3.1 (G), R8.2, U1.15 (GPIO9)
/microcontroller/SAO IO1: J1.5 (IO1), U1.8 (GPIO0/ADC1_CH0/XTAL_32K_P)
/microcontroller/SAO IO2: J1.6 (IO2), U1.9 (GPIO1/ADC1_CH1/XTAL_32K_N)
/microcontroller/SDCARD CS: J3.2 (DAT3/CD), R1.2, U1.16 (GPIO18)
/microcontroller/SPI MISO: J3.7 (DAT0), U1.18 (GPIO20)
GND: C1.2, C2.1, C4.2, C5.2, C6.2, C7.1, C9.1, C10.2, C11.2, C12.2, C13.2, C15.2, C16.1, C17.1, C18.1, C19.1, C20.1, C21.1, C22.1, C23.1, D2.1 (K), J1.2 (GND), J3.6 (VSS), J3.9 (SHIELD), J4.A1 (GND), J4.A12 (GND), J4.B1 (GND), J4.B12 (GND), J4.S1 (SHIELD), J5.1, J5.MP (MountPin), J6.8, J6.17, J6.MP (MountPin), Q1.2 (S), Q3.2 (S), R4.1, R5.1, R11.2, R13.1, R16.1, R19.1, R20.1, R21.1, R31.1, U1.1 (GND), U1.12 (GPIO11), U1.28 (GND), U1.29 (GND), U2.2 (GND), U3.2 (VSS), U4.2 (GND), U5.4 (VSS), U5.21 (VSS)
LED A: R27.1, U5.5 (PD0)
LED B: R26.1, U5.7 (PC0)
LED C: R25.1, U5.2 (PA1)
LED D: R24.1, U5.10 (PC3)
LED E: R23.1, U5.3 (PA2)
MSWB: R29.2, SW1.T, SW2.T, SW3.T, SW4.T, SW5.T, U5.13 (PC6)
MSWL: R28.2, SW1.2, SW2.2, SW3.2, SW4.2, SW5.2, U5.14 (PC7)
MSWR: R30.2, SW1.1, SW2.1, SW3.1, SW4.1, SW5.1, U5.12 (PC5)
MSWS1: SW1.C, U5.20 (PD6)
MSWS2: SW2.C, U5.19 (PD5)
MSWS3: SW3.C, U5.18 (PD4)
MSWS4: SW4.C, U5.17 (PD3)
MSWS5: SW5.C, U5.16 (PD2)
unnamed: C14.1, D2.2 (A), D3.1 (K)
unnamed: C14.2, D4.2 (A), L2.2, Q2.3 (D)
unnamed: D25.2 (A), K1.2, Q3.3 (D)
unnamed: J2.1, K1.4
unnamed: J2.2, K1.3
unnamed: J2.3, K1.1
unnamed: C20.2, J6.7, R22.2
unnamed: Q1.3 (D), R17.2, U4.4 (ON)
unnamed: Q1.1 (G), R15.2, R16.2
unnamed: R17.1, R31.2, SW6.2 (B), U4.5 (IN)
unnamed: C1.1, R6.1, U1.3 (EN/CHIP_PU)
unnamed: R10.2, U1.13 (GPIO12/USB_D-)
unnamed: R9.2, U1.14 (GPIO13/USB_D+)
unnamed: R13.2, U3.5 (PROG)
unnamed: R20.2, U4.3 (SET)
SCL: J1.4 (SCL), R2.1, U1.7 (MTDO/GPIO7), U5.9 (PC2)
SDA: J1.3 (SDA), R3.1, U1.6 (MTCK/GPIO6/ADC1_CH6), U5.8 (PC1)
VBAT: C12.1, J5.2, R18.2, SW6.1 (A), U3.3 (VBAT)
VIN: C5.1, C6.1, D1.1 (K), D25.1 (K), K1.5, U2.1 (EN), U2.4 (VIN), U4.1 (OUT)
VUSB: C7.2, C9.2, D1.2 (A), F1.1, R15.1, U3.4 (VDD)
