badgeteam/hackerhotel-2024-hardware/(commit log)

2023-06-13 First commit with empty project
    [hackerhotel-2024-hardware.kicad_pcb, hackerhotel-2024-hardware.kicad_sch]
2023-06-16 Add USB-C, Power regulator and the basics for the RP2040
    [hackerhotel-2024-hardware.kicad_sch]
2023-06-16 Add usb hub and wireup the usb ports
    [hackerhotel-2024-hardware.kicad_sch]
2023-06-16 Add a part reference
    [hackerhotel-2024-hardware.kicad_sch]
2023-10-12 V1 of schematic
    [audio.kicad_sch, epaper.kicad_sch, hackerhotel-2024-hardware.kicad_pcb, hh2024.kicad_pcb, hh2024.kicad_sch, microcontroller.kicad_sch, mma8452qr1.kicad_sch, powermanagement.kicad_sch]
2023-10-12 V1.1 schematic
    Added a relay for clicking noise
    Multiplexed the switches and moved them all to the CH32
    Wired an ESP32 low power triggered pin (GPIO4) to PC4 on the CH32 so it can wake it up on input change
    [hh2024.kicad_sch, microcontroller.kicad_sch]
2023-10-12 V1.1 Continued
    Added a pull up on CH32 prog
    [microcontroller.kicad_sch]
2023-10-13 Started layout
    [epaper.kicad_sch, hh2024.kicad_pcb, hh2024.kicad_sch, microcontroller.kicad_sch, powermanagement.kicad_sch]
2023-10-14 removed extra pull ups on multi switches
    [hh2024-B_Cu.gbr, hh2024-B_Mask.gbr, hh2024-B_Paste.gbr, hh2024-B_Silkscreen.gbr, hh2024-Edge_Cuts.gbr, hh2024-F_Cu.gbr, hh2024-F_Mask.gbr, hh2024-F_Paste.gbr]
2023-10-15 Routing complete (apart from LEDs)
    [hh2024.kicad_pcb, hh2024.kicad_sch]
2023-10-16 routing almost finished
    [hh2024.kicad_pcb, hh2024.kicad_sch]
2023-10-17 Added artwork + more routing
    [epaper.kicad_sch, hh2024.kicad_pcb, hh2024.kicad_sch, microcontroller.kicad_sch, powermanagement.kicad_sch]
2023-10-18 Routing and BOM completed, missing art and regulator update
    [epaper.kicad_sch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]
2023-10-20 V1 complete
    [hh2024.kicad_sch, microcontroller.kicad_sch]
2023-10-21 Fixed the soldermask under the LEDs
    [hh2024-B_Cu.gbr, hh2024-B_Fab.gbr, hh2024-B_Mask.gbr, hh2024-B_Paste.gbr, hh2024-B_Silkscreen.gbr, hh2024-Edge_Cuts.gbr, hh2024-F_Cu.gbr, hh2024-F_Mask.gbr]
2023-11-26 before tidy
    [hh2024.kicad_sch, microcontroller.kicad_sch]
2023-11-26 After tidy
    [audio.kicad_sch, epaper.kicad_sch, hackerhotel-2024-hardware.kicad_pcb, hackerhotel-2024-hardware.kicad_sch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]
2023-11-29 Annoted schematic with letters for LEDs
    [bom.xls]
2023-12-03 V1.1 almost complete update
    ✔️add a 100k resistor between the gate of the FET in the epaper circuit and ground
    ✔️Moved LEDs to match the alignment on line “HIKL” and “Y”
    ✔️Change polarity on the LEDs, they are the “wrong way around” (software thing only, doesn’t matter for charlieplexing
    -Add relay control on PD7 (if it can be changed)
    ✔️Swap PA1 and PA2 with PD3 and PD2
    ✔️ Prog pads for CH32
    ✔️Connect SAO IOs to relay output (to make an add-on glow when the relay ticks), pulled low by default.
    ✔️ Move relay
    [epaper.kicad_sch, hh2024.kicad_sch]
2023-12-05 V1.2
    added reverse mount RGB LED
    [epaper.kicad_sch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]
2023-12-05 Added battery cycle ch/dis curve
2023-12-10 generated gerbers
2023-12-10 V1.3
    Moved routing of CH32 top layer tracks
    Moved SD card inward
    added keepout on relay
2023-12-12 V1.3
    Changed C23 from 1uF to 0.47uF
    Changed R21 from 27ohms to 2.2ohms
    Changed C17 from 4.7uF to 1uF
    Removed R37 and R38, R39 and R40
    Added J2 QWIIC connector
    Added U6 buffer to drive SK6085 LED
    Removed R33 to a direct wire connection
    [epaper.kicad_sch, hh2024.kicad_sch]
2023-12-13 removed connection from LEDs to CH32
    [hh2024.kicad_sch]
2023-12-13 Fixed the sao ヽ༼ ツ ༽ﾉ
    and some routing
    [hh2024.kicad_sch]
2023-12-15 Small fixes and change footprint library for missing libraries
    [epaper.kicad_sch, hh2024.kicad_sch, microcontroller.kicad_sch, powermanagement.kicad_sch]
2023-12-16 Fix power circuit, add headers and move stuff
    [epaper.kicad_sch, hh2024.kicad_sch, microcontroller.kicad_sch, powermanagement.kicad_sch]
2023-12-16 Added art, first pass without DRC
    [hh2024.kicad_sch]
2023-12-16 Added artwork (cont)
    DRC pass
    Removed header from the BoM
    changed the relay header to SMD so it doesn't clash with art
    made header for CH32 prog THT
    Moved designators in reasonable place
    added hacker hotel and badge.team artwork
    [hh2024.kicad_sch, microcontroller.kicad_sch]
2023-12-16 updated the switched and routing around it
2023-12-17 Moar headers
    [epaper.kicad_sch, hh2024.kicad_sch, microcontroller.kicad_sch, powermanagement.kicad_sch]
2023-12-17 tidy silk and solved DRC errors
    [epaper.kicad_sch, hh2024.kicad_sch]
2023-12-17 V1.4
    Swapped back PA1 and PA2 with PD3 and PD2 since Renze got them working
    7 errors of copper which bleeds over edgecut
    117 warning of soldermask bridging
    generated bom, gerber, placement files and schematic
    [epaper.kicad_sch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]
2023-12-17 updated the f.mask art and moved 2 tracks
    [hh2024-B_Cu.gbr, hh2024-B_Mask.gbr, hh2024-B_Paste.gbr, hh2024-B_Silkscreen.gbr, hh2024-Edge_Cuts.gbr, hh2024-F_Cu.gbr, hh2024-F_Mask.gbr, hh2024-F_Paste.gbr]
2023-12-17 Update Gerbers V1.4.zip
2023-12-17 fixed a copper not fully filled in the diamond
    [hh2024-B_Cu.gbr, hh2024-B_Mask.gbr, hh2024-B_Paste.gbr, hh2024-B_Silkscreen.gbr, hh2024-Edge_Cuts.gbr, hh2024-F_Cu.gbr, hh2024-F_Mask.gbr, hh2024-F_Paste.gbr]
2024-03-01 Remove unused file
    [mma8452qr1.kicad_sch]
