badgeteam/hackerhotel-2024-hardware/(notices)

Notices in the files:
audio.kicad_sch:
License: CERN Open Hardware Licence Version 2 - Permissive
